YilunAllenChen/SlothBot_v2/SlothBot_Cloud/cecropia-dashboard/src/media/youssef.jpg

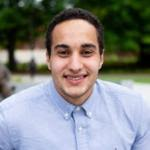
SlothBot_Cloud/cecropia-dashboard/src/media/youssef.jpg
