YilunAllenChen/SlothBot_v2/SlothBot_Cloud/cecropia-dashboard/src/media/cecropia.png

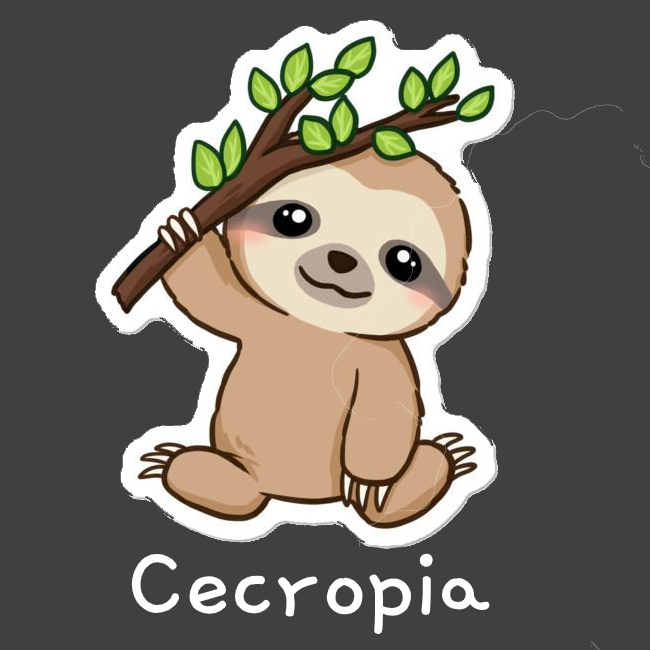
SlothBot_Cloud/cecropia-dashboard/src/media/cecropia.png
