YilunAllenChen/SlothBot_v2/README.md

# SlothBot_v2.0
The SlothBot project, v2.0. Since 2020.
