YilunAllenChen/SlothBot_v2/SlothBot_Electrical/slothbot_2.1_top_bom.csv

Comment | Designator | Footprint | LCSC Part #
10K? | R2 R7 | R3216
220? | R4 R5 R6 | R3216
LED | LED1 LED2 LED3 | R3216
