YilunAllenChen/SlothBot_v2/SlothBot_Mechanical/Assemblies/Head.SLDASM

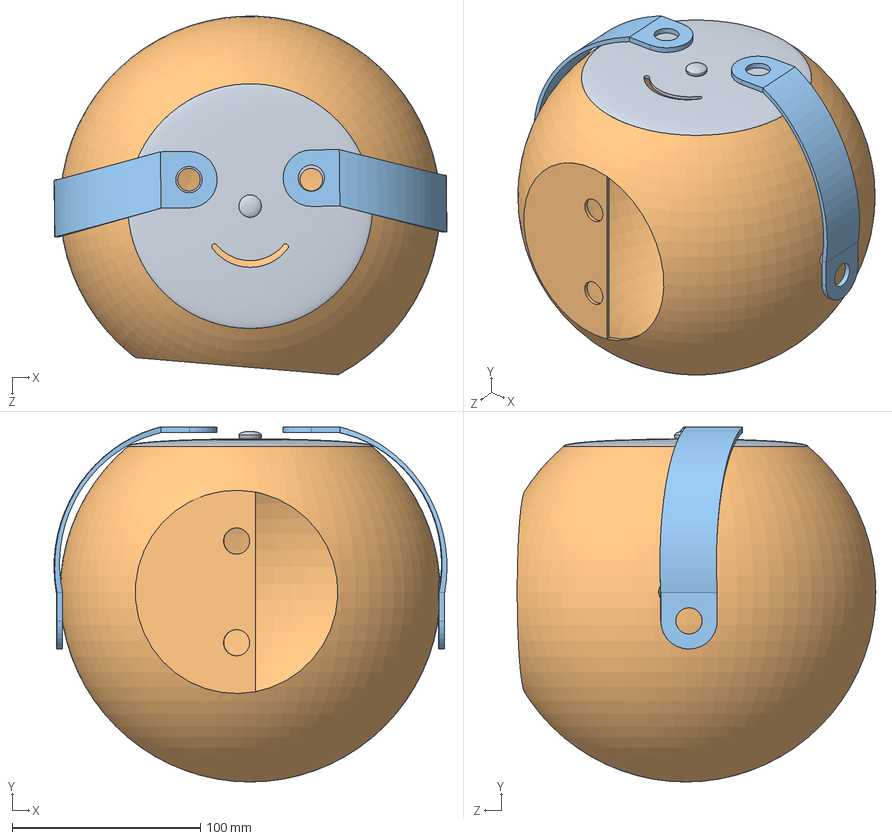
[picture p3: CAD file, 2021-05-13]
SlothBot_Mechanical/Assemblies/Head.SLDASM
208.8 x 188.6 x 190.5 mm
Headshell
Eyes2
