YilunAllenChen/SlothBot_v2/SlothBot_Mechanical/Assemblies/Body.SLDASM

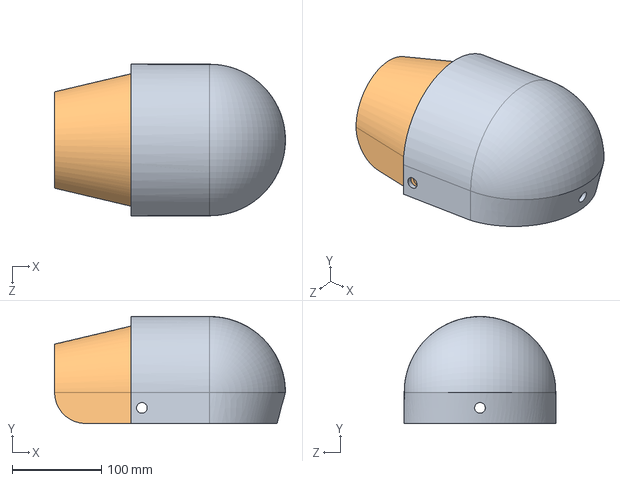
[picture p4: CAD file, 2021-05-13]
SlothBot_Mechanical/Assemblies/Body.SLDASM
259.0 x 120.0 x 170.0 mm
Back Shell
Front Shell
