YilunAllenChen/SlothBot_v2/SlothBot_Mechanical/Assemblies/BoxAssembly.SLDASM

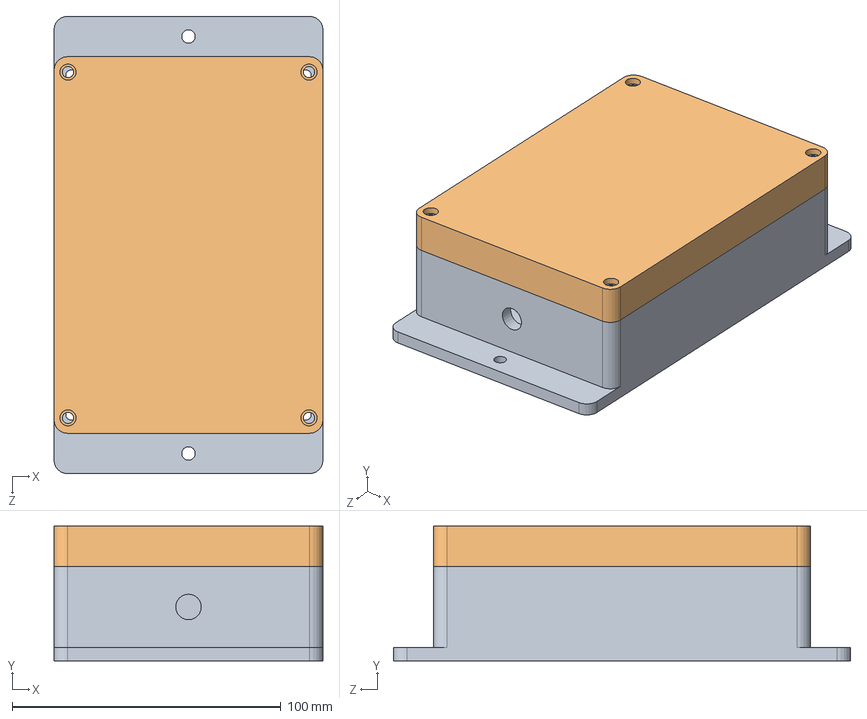
[picture p5: CAD file, 2021-05-13]
SlothBot_Mechanical/Assemblies/BoxAssembly.SLDASM
100.0 x 50.0 x 170.0 mm
Base1
Top V2
