YilunAllenChen/SlothBot_v2/SlothBot_Mechanical/Assemblies/FullAssembly.SLDASM

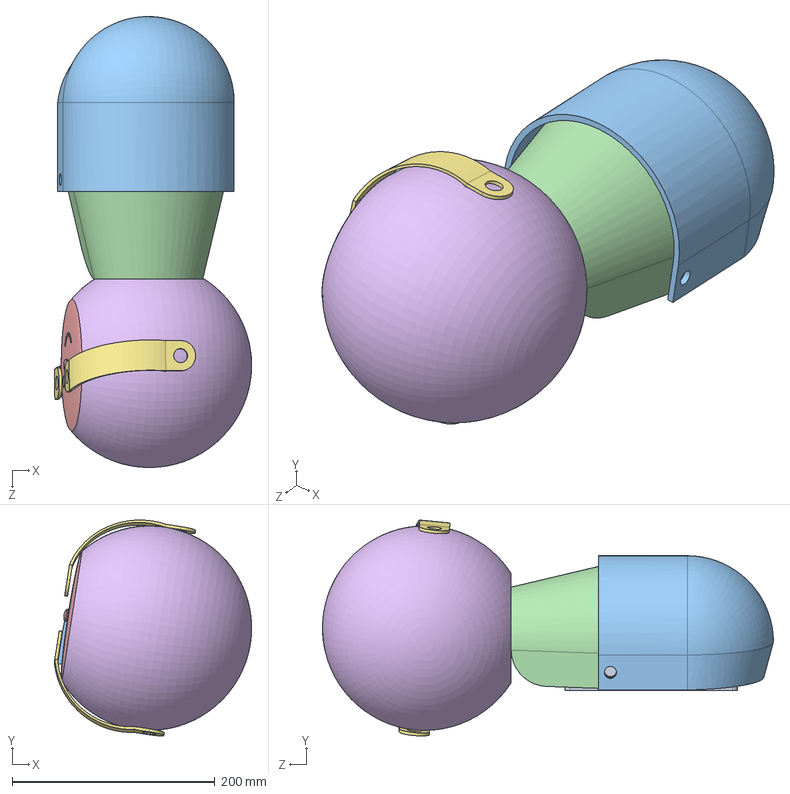
[picture p6: CAD file, 2021-05-13]
SlothBot_Mechanical/Assemblies/FullAssembly.SLDASM
194.8 x 213.2 x 445.3 mm
Base1
Top V2
Back Shell
Front Shell
Headshell
Eyes2
