YilunAllenChen/SlothBot_v2/SlothBot_Mechanical/Body/Eyes2.SLDPRT

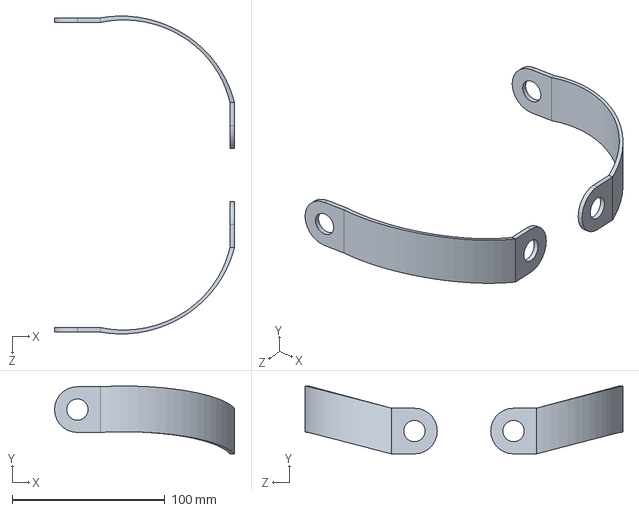
[picture p7: CAD file, 2021-05-13]
SlothBot_Mechanical/Body/Eyes2.SLDPRT
118.0 x 44.5 x 208.4 mm
