YilunAllenChen/SlothBot_v2/SlothBot_Mechanical/Waterproof/Top V2.SLDPRT

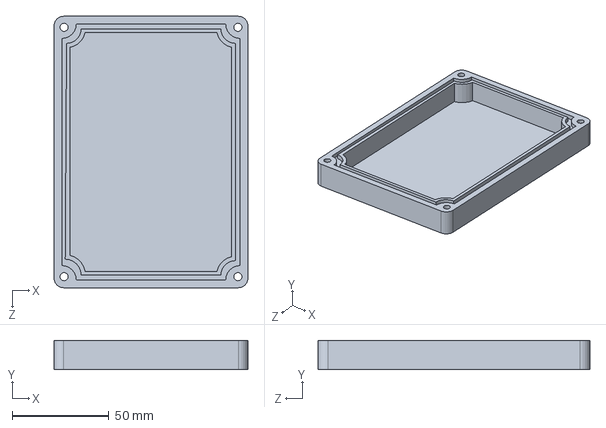
[picture p8: CAD file, 2021-05-13]
SlothBot_Mechanical/Waterproof/Top V2.SLDPRT
100.0 x 15.0 x 140.0 mm
