YilunAllenChen/SlothBot_v2/SlothBot_Mechanical/Body/Front Shell.SLDPRT

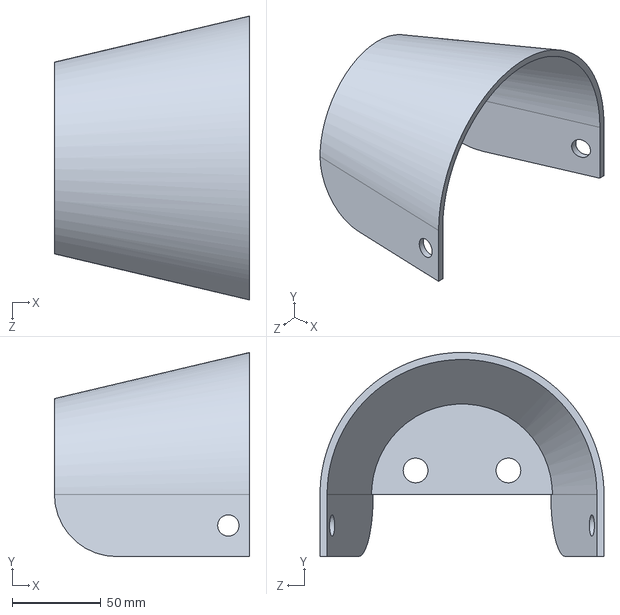
[picture p9: CAD file, 2021-05-13]
SlothBot_Mechanical/Body/Front Shell.SLDPRT
110.0 x 115.0 x 160.0 mm
