YilunAllenChen/SlothBot_v2/SlothBot_Mechanical/Waterproof/Base1.SLDPRT

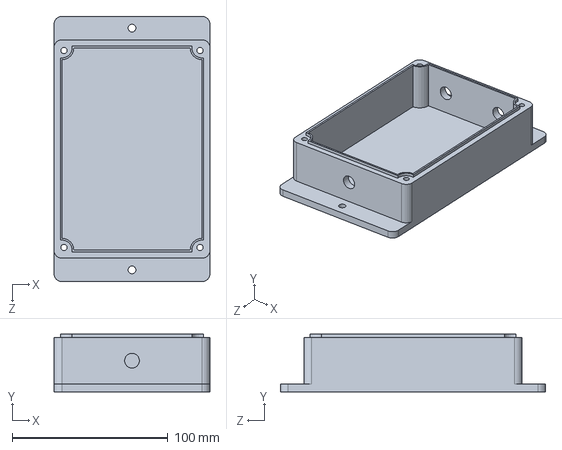
[picture p10: CAD file, 2021-05-13]
SlothBot_Mechanical/Waterproof/Base1.SLDPRT
100.0 x 37.0 x 170.0 mm
