YilunAllenChen/SlothBot_v2/SlothBot_Mechanical/Body/Headshell.SLDPRT

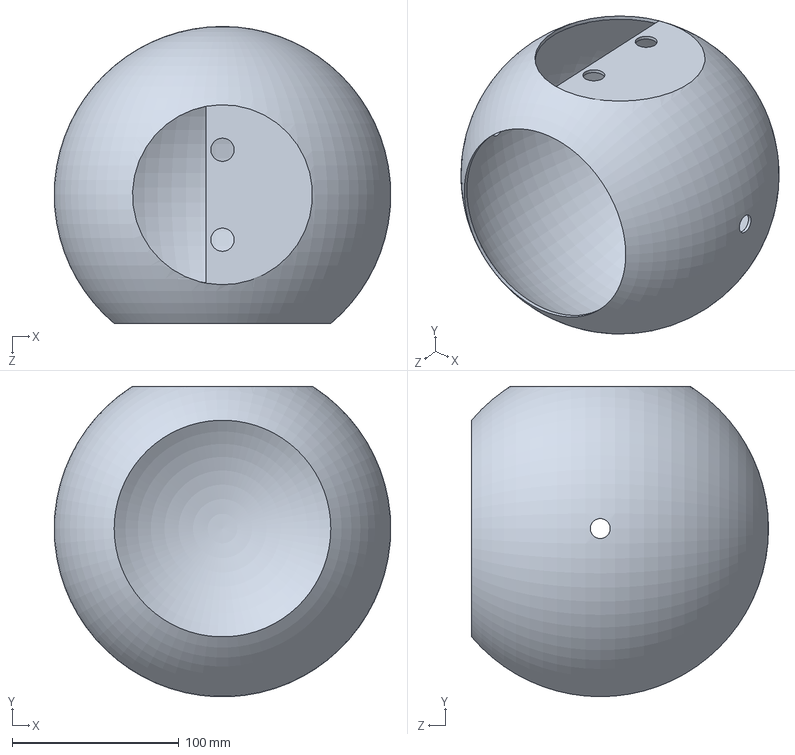
[picture p11: CAD file, 2021-05-13]
SlothBot_Mechanical/Body/Headshell.SLDPRT
201.6 x 186.3 x 178.3 mm
