YilunAllenChen/SlothBot_v2/SlothBot_Mechanical/Body/shell_front.SLDPRT

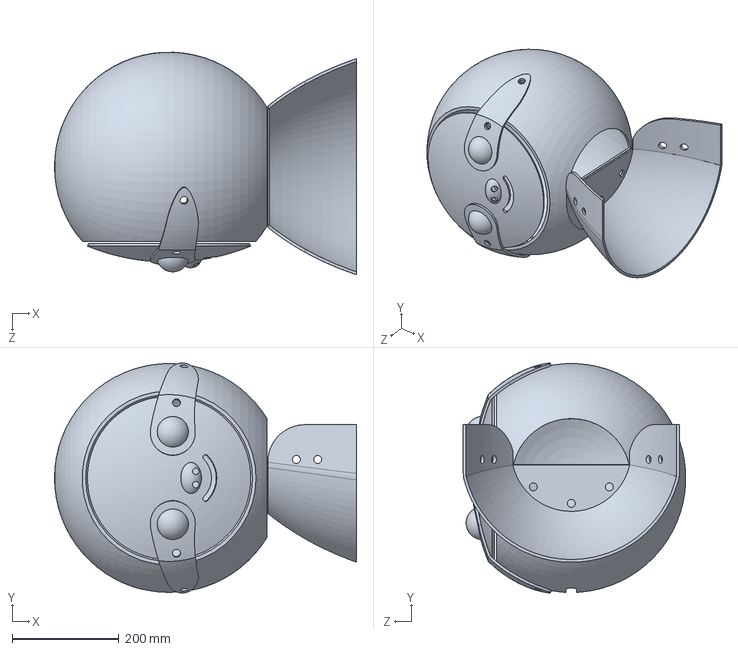
[picture p12: CAD file, 2021-05-13]
SlothBot_Mechanical/Body/shell_front.SLDPRT
566.7 x 431.5 x 417.5 mm
