YilunAllenChen/SlothBot_v2/SlothBot_Mechanical/Body/Back Shell.SLDPRT

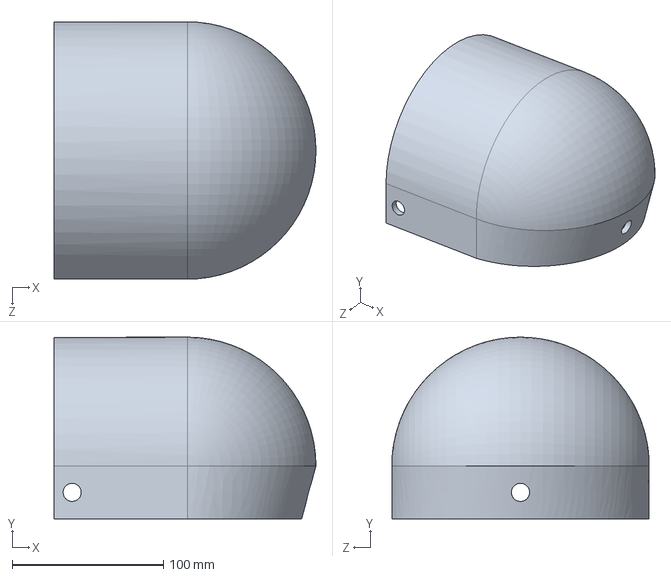
[picture p13: CAD file, 2021-05-13]
SlothBot_Mechanical/Body/Back Shell.SLDPRT
173.0 x 120.0 x 170.0 mm
