YilunAllenChen/SlothBot_v2/SlothBot_Electrical/slothbot_2.2b.brd

## EAGLE design SlothBot_Electrical/slothbot_2.2b.brd (2021-05-24)

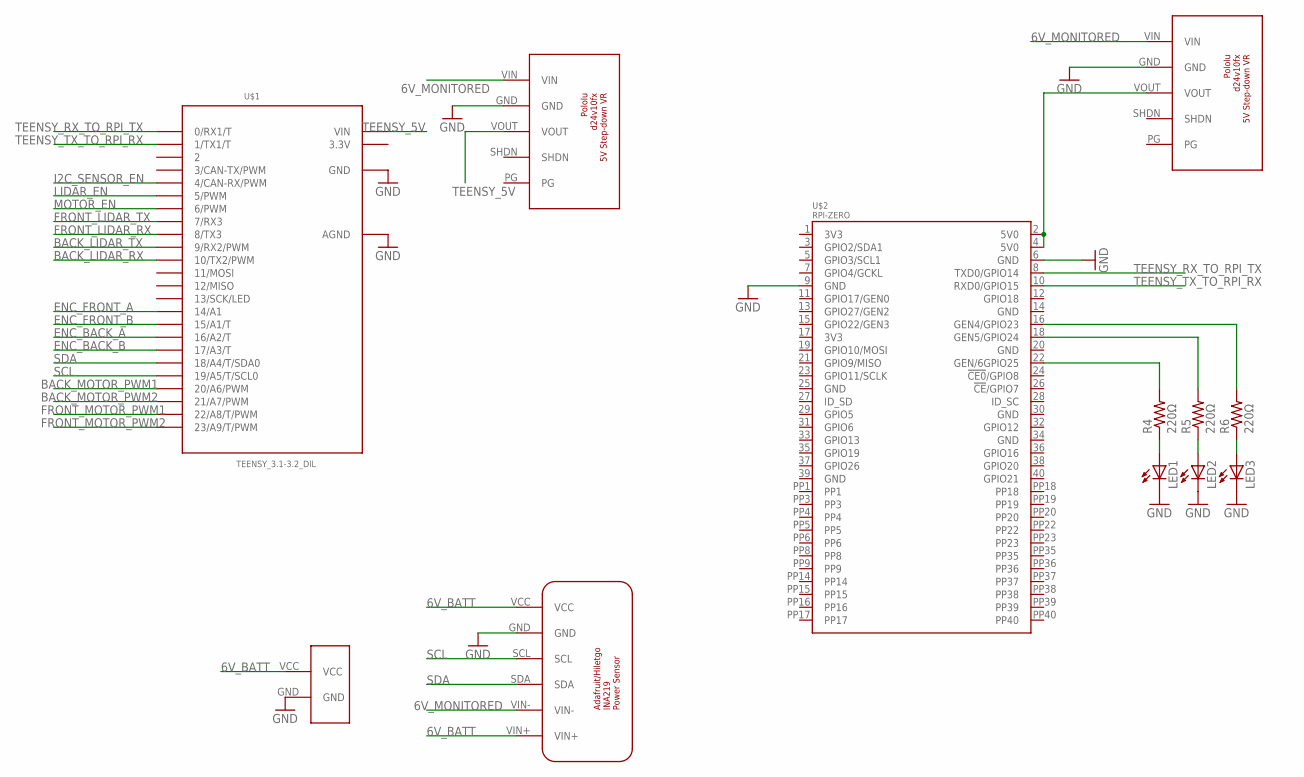
[picture p14: schematic slothbot_2.2b.sch, sheet 1, Logical Components]

Parts:
LED1, LED2, LED3: LEDCHIPLED_0603; CHIPLED_0603
R4, R5, R6: 220Ω; R3216
U$1: TEENSY_3.1-3.2_DIL; TEENSY_3.0-3.2&LC_DIL
U$2: RPI-ZERO; RASP_PI_ZERO_BOARD_FULL
U$12, U$13: D24V10FX
U$15: INA219
U$16: BATTERY_CONNECTOR

Connections:
3.3V: U$1.3.3V
5V0@1: U$2.2 (5V0), U$2.4 (5V0), U$13.VOUT
6V_BATT: U$15.VCC, U$15.VIN+, U$16.VCC
6V_MONITORED: U$12.VIN, U$13.VIN, U$15.VIN-; also elsewhere on the board
BACK_LIDAR_RX: U$1.10 (10/TX2/PWM); also elsewhere on the board
BACK_LIDAR_TX: U$1.9 (9/RX2/PWM); also elsewhere on the board
BACK_MOTOR_PWM1: U$1.20/A6 (20/A6/PWM); also elsewhere on the board
BACK_MOTOR_PWM2: U$1.21/A7 (21/A7/PWM); also elsewhere on the board
ENC_BACK_A: U$1.16/A2 (16/A2/T); also elsewhere on the board
ENC_BACK_B: U$1.17/A3 (17/A3/T); also elsewhere on the board
ENC_FRONT_A: U$1.14/A0 (14/A1); also elsewhere on the board
ENC_FRONT_B: U$1.15/A1 (15/A1/T); also elsewhere on the board
FRONT_LIDAR_RX: U$1.8 (8/TX3); also elsewhere on the board
FRONT_LIDAR_TX: U$1.7 (7/RX3); also elsewhere on the board
FRONT_MOTOR_PWM1: U$1.22/A8 (22/A8/T/PWM); also elsewhere on the board
FRONT_MOTOR_PWM2: U$1.23/A9 (23/A9/T/PWM); also elsewhere on the board
GND: LED1.C, LED2.C, LED3.C, U$1.AGND, U$1.GND, U$2.6 (GND), U$12.GND, U$13.GND, U$15.GND, U$16.GND; also elsewhere on the board
GND@1: U$2.9 (GND)
I2C_SENSOR_EN: U$1.4 (4/CAN-RX/PWM); also elsewhere on the board
LIDAR_EN: U$1.5 (5/PWM); also elsewhere on the board
MOTOR_EN: U$1.6 (6/PWM); also elsewhere on the board
unnamed: LED1.A, R4.1
unnamed: LED2.A, R5.1
unnamed: LED3.A, R6.1
unnamed: R6.2, U$2.16 (GEN4/GPIO23)
unnamed: R5.2, U$2.18 (GEN5/GPIO24)
unnamed: R4.2, U$2.22 (GEN/6GPIO25)
SCL: U$1.19/A5 (19/A5/T/SCL0), U$15.SCL; also elsewhere on the board
SDA: U$1.18/A4 (18/A4/T/SDA0), U$15.SDA; also elsewhere on the board
TEENSY_5V: U$1.VIN, U$12.VOUT; also elsewhere on the board
TEENSY_RX_TO_RPI_TX: U$1.0 (0/RX1/T), U$2.8 (TXD0/GPIO14)
TEENSY_TX_TO_RPI_RX: U$1.1 (1/TX1/T), U$2.10 (RXD0/GPIO15)

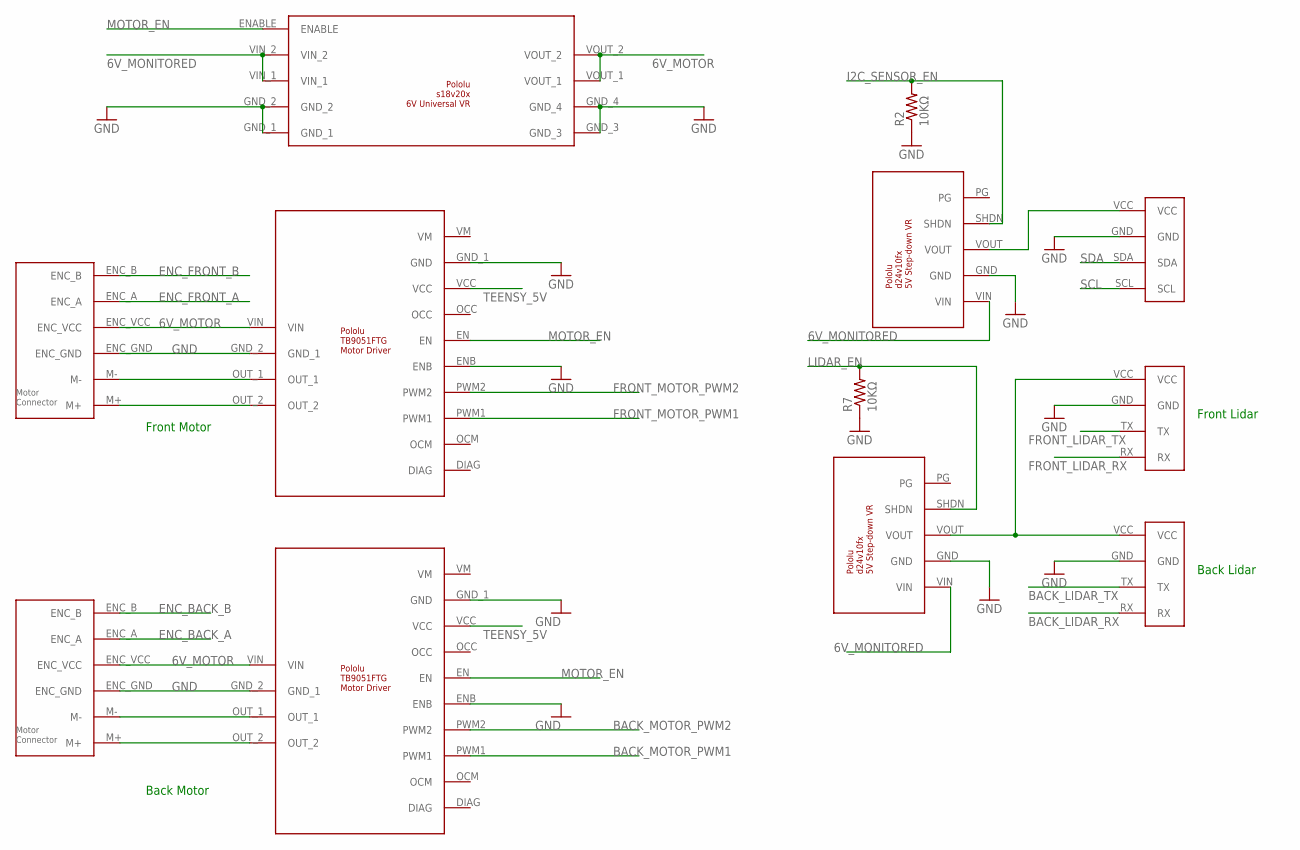
[picture p15: schematic slothbot_2.2b.sch, sheet 2, Sensor and motors]

Parts:
R2, R7: 10KΩ; R3216
U$3, U$14: D24V10FX
U$4, U$5: MOTOR_CONNECTOR
U$6, U$7: SERIAL_CONNECTOR
U$8: I2C_CONNECTOR
U$9, U$10: TB9051FTG
U$11: S18V20X; S18V20F6

Connections:
6V_MONITORED: U$3.VIN, U$11.VIN_1, U$11.VIN_2, U$14.VIN; also elsewhere on the board
6V_MOTOR: U$4.ENC_VCC, U$5.ENC_VCC, U$9.VIN, U$10.VIN, U$11.VOUT_1, U$11.VOUT_2
BACK_LIDAR_RX: U$6.RX; also elsewhere on the board
BACK_LIDAR_TX: U$6.TX; also elsewhere on the board
BACK_MOTOR_PWM1: U$10.PWM1; also elsewhere on the board
BACK_MOTOR_PWM2: U$10.PWM2; also elsewhere on the board
ENC_BACK_A: U$5.ENC_A; also elsewhere on the board
ENC_BACK_B: U$5.ENC_B; also elsewhere on the board
ENC_FRONT_A: U$4.ENC_A; also elsewhere on the board
ENC_FRONT_B: U$4.ENC_B; also elsewhere on the board
FRONT_LIDAR_RX: U$7.RX; also elsewhere on the board
FRONT_LIDAR_TX: U$7.TX; also elsewhere on the board
FRONT_MOTOR_PWM1: U$9.PWM1; also elsewhere on the board
FRONT_MOTOR_PWM2: U$9.PWM2; also elsewhere on the board
GND: R2.1, R7.1, U$3.GND, U$4.ENC_GND, U$5.ENC_GND, U$6.GND, U$7.GND, U$8.GND, U$9.ENB, U$9.GND_1 (GND), U$9.GND_2 (GND_1), U$10.ENB, U$10.GND_1 (GND), U$10.GND_2 (GND_1), U$11.GND_1, U$11.GND_2, U$11.GND_3, U$11.GND_4, U$14.GND; also elsewhere on the board
I2C_SENSOR_EN: R2.2, U$14.SHDN; also elsewhere on the board
LIDAR_EN: R7.2, U$3.SHDN; also elsewhere on the board
MOTOR_EN: U$9.EN, U$10.EN, U$11.ENABLE; also elsewhere on the board
unnamed: U$3.VOUT, U$6.VCC, U$7.VCC
unnamed: U$4.M-, U$9.OUT_1
unnamed: U$4.M+, U$9.OUT_2
unnamed: U$5.M-, U$10.OUT_1
unnamed: U$5.M+, U$10.OUT_2
unnamed: U$8.VCC, U$14.VOUT
SCL: U$8.SCL; also elsewhere on the board
SDA: U$8.SDA; also elsewhere on the board
TEENSY_5V: U$9.VCC, U$10.VCC; also elsewhere on the board

Notes on the sheet:
Front Motor
Back Motor
Front Lidar
Back Lidar

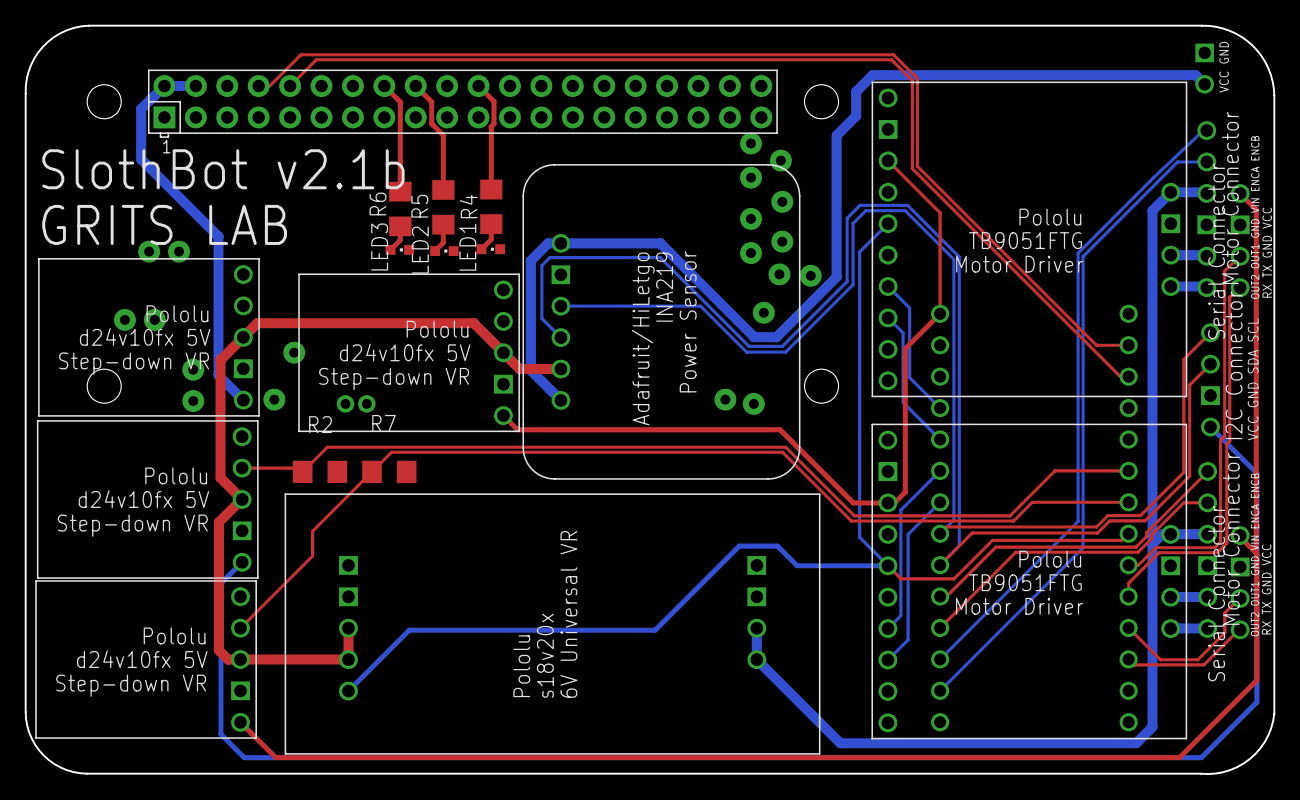
[picture p16: board slothbot_2.2b.brd from above]

Board: 2 copper layers, 101.0 x 60.5 mm, 24 parts (1 on the bottom side), 37 nets.
