YilunAllenChen/SlothBot_v2/SlothBot_Electrical/slothbot_sensor_unit_3.0.brd

## EAGLE design SlothBot_Electrical/slothbot_sensor_unit_3.0.brd (2021-05-08)

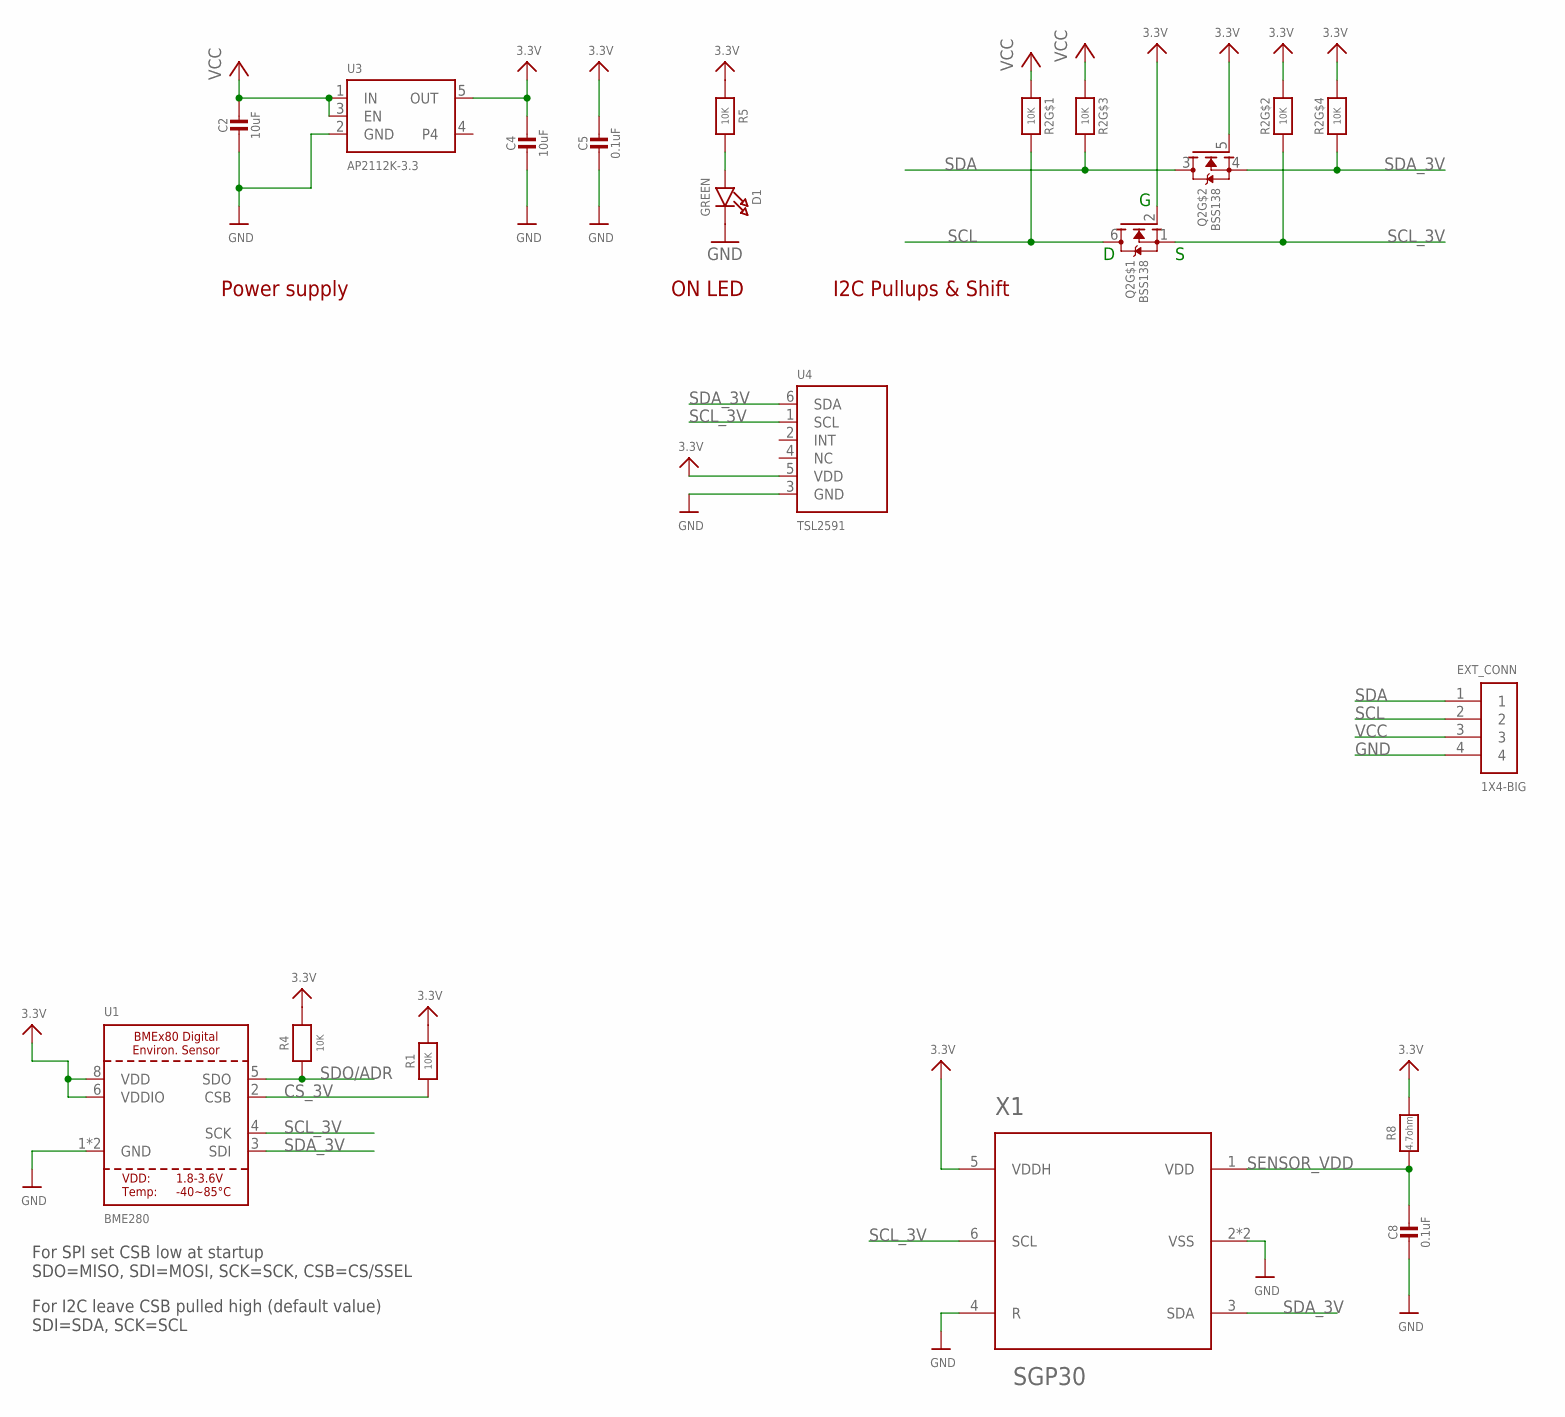
[picture p17: schematic slothbot_sensor_unit_3.0.sch, BME280's breakout board, BME680 Provided by Adafruit: https…]

Parts:
C2, C4: 10uF; 0805-NO
C5, C8: 0.1uF; 0603-NO
D1: GREEN; CHIPLED_0603_NOOUTLINE
EXT_CONN: 1X4-BIG; 1X04-BIG
Q2: BSS138; SOT363
R1, R4, R5: 10K; 0603-NO
R2: 10K; RESPACK_4X0603
R8: 4.7ohm; 0603-NO
U1: BME280
U3: AP2112K-3.3; SOT23-5
U4: TSL2591; DFN6_TAOS
X1: SGP30

Connections:
3.3V: C4.1, C5.1, Q2.2 (G), Q2.5 (G), R1.2, R2.2 (1), R2.4 (1), R4.2, R5.1, R8.2, U1.6 (VDDIO), U1.8 (VDD), U3.5 (OUT), U4.5 (VDD), X1.5 (VDDH)
CS_3V: R1.1, U1.2 (CSB)
GND: C2.2, C4.2, C5.2, C8.2, D1.C, EXT_CONN.4, U1.1 (GND), U1.7 (GND), U3.2 (GND), U4.3 (GND), X1.2 (VSS), X1.4 (R), X1.P$7 (VSS)
unnamed: D1.A, R5.2
SCL: EXT_CONN.2, Q2.6 (D), R2.8 (2)
SCL_3V: Q2.1 (S), R2.7 (2), U1.4 (SCK), U4.1 (SCL), X1.6 (SCL)
SDA: EXT_CONN.1, Q2.3 (D), R2.6 (2)
SDA_3V: Q2.4 (S), R2.5 (2), U1.3 (SDI), U4.6 (SDA), X1.3 (SDA)
SDO/ADR: R4.1, U1.5 (SDO)
SENSOR_VDD: C8.1, R8.1, X1.1 (VDD)
VCC: C2.1, EXT_CONN.3, R2.1, R2.3 (1), U3.1 (IN), U3.3 (EN)

Notes on the sheet:
For SPI set CSB low at startup SDO=MISO, SDI=MOSI, SCK=SCK, CSB=CS/SSEL
For I2C leave CSB pulled high (default value) SDI=SDA, SCK=SCL
I2C Pullups & Shift
ON LED
Power supply

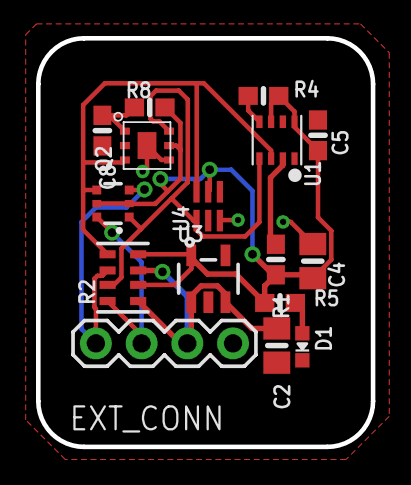
[picture p18: board slothbot_sensor_unit_3.0.brd from above]

Board: 2 copper layers, 18.6 x 22.7 mm, 16 parts (0 on the bottom side), 11 nets.
