YilunAllenChen/SlothBot_v2/SlothBot_Firmware/RPi/programs/led_blink.py

import RPi.GPIO as GPIO
import time
import pathlib
import logging
pathlib.Path("./logs").mkdir(parents=True, exist_ok=True)
logger = logging.getLogger("led")
logger.setLevel("INFO")
f_handler = logging.FileHandler("logs/led.log", "a+")
f_handler.setFormatter(logging.Formatter("[%(asctime)s] [%(levelname)s] %(message)s"))
logger.addHandler(f_handler)

GPIO.setmode(GPIO.BCM)
GPIO.setwarnings(False)
GPIO.setup(23,GPIO.OUT)


while True: 
    logger.info("LED on")
    GPIO.output(23,GPIO.HIGH)
    time.sleep(0.3)
    logger.info("LED off")
    GPIO.output(23,GPIO.LOW)
    time.sleep(1)
