YilunAllenChen/SlothBot_v2/(commit log)

2021-05-08 schematics/pcb added
    [slothbot_2.0.brd, slothbot_2.0.sch]
2021-05-08 reorganized files; added pcb
    [slothbot_3.0.brd, slothbot_3.0.sch, slothbot_sensor_unit_3.0.brd, slothbot_sensor_unit_3.0.sch]
2021-05-10 new pcb added
    [slothbot_2.1.brd, slothbot_2.1.sch, slothbot_2.1_top_bom.csv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]
2021-05-13 updated mechanical parts
    [Back Shell.SLDPRT, Base1.SLDPRT, Body.SLDASM, BoxAssembly.SLDASM, Eyes2.SLDPRT, Front Shell.SLDPRT, FullAssembly.SLDASM, Head.SLDASM]
2021-05-24 updated setup script; modified led blink to comply with SlothBot v2.2; fixed errors in main.py
    [led_blink.py, main.py]
2021-05-24 redid setup script using system d
    [slothbot_2.2.brd, slothbot_2.2.sch, slothbot_2.2_top_bom.csv, slothbot_2.2b.brd, slothbot_2.2b.sch, slothbot_2.2b_top_bom.csv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]
2021-05-24 repo watcher now works with led
2021-05-24 fix for led blink
    [led_blink.py]
2021-05-24 testing autodeploy with decreased led blinking interval
2021-05-24 increasing led interval
2021-05-25 testing LED autodeploy
2021-06-05 added cloud comm and print ip addr
2021-06-05 moved teensy bin around
2021-06-05 command center improved; added sensor data
2021-06-07 firmware update to prevent cloud comm from breaking
    [cloud_comm.py]
2021-06-08 retry for failed connection
    [cloud_comm.py]
2021-06-08 detached instruction handling from updating sensor data
2021-06-08 printing for cloud comm for debug
2021-06-08 changing board mode to BOARD
2021-06-08 better error handling updating data
    [cloud_comm.py]
2021-06-08 temp removed read data button
2021-06-08 uploading serial comm code to teensy
2021-06-10 using per stage update instead of multiple updates
2021-06-12 prevent rpi to override sent instruction while pulling for instruction
    [cloud_comm.py]
